BenKohn2004/LFC_Overlay_and_Camera_Tracking/Raspberry_Pi_Station/assets/Blue Rectangle.png

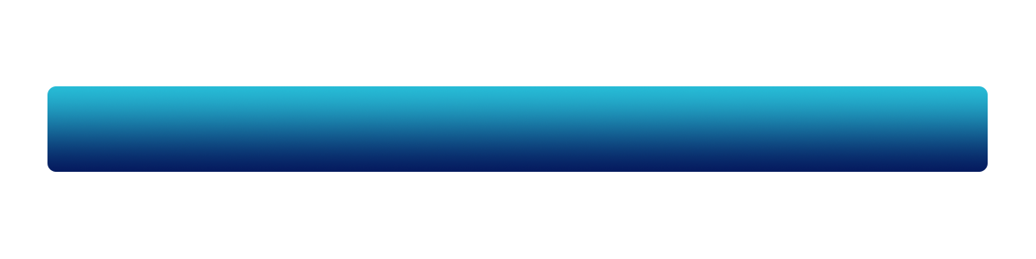
Raspberry_Pi_Station/assets/Blue Rectangle.png
