BenKohn2004/LFC_Overlay_and_Camera_Tracking/Scoring Machine Integration/Schematic_Favero-Parser-and-Receiver_2025-12-16.pdf

# Favero Parser and Transmitter Receiver and Relays

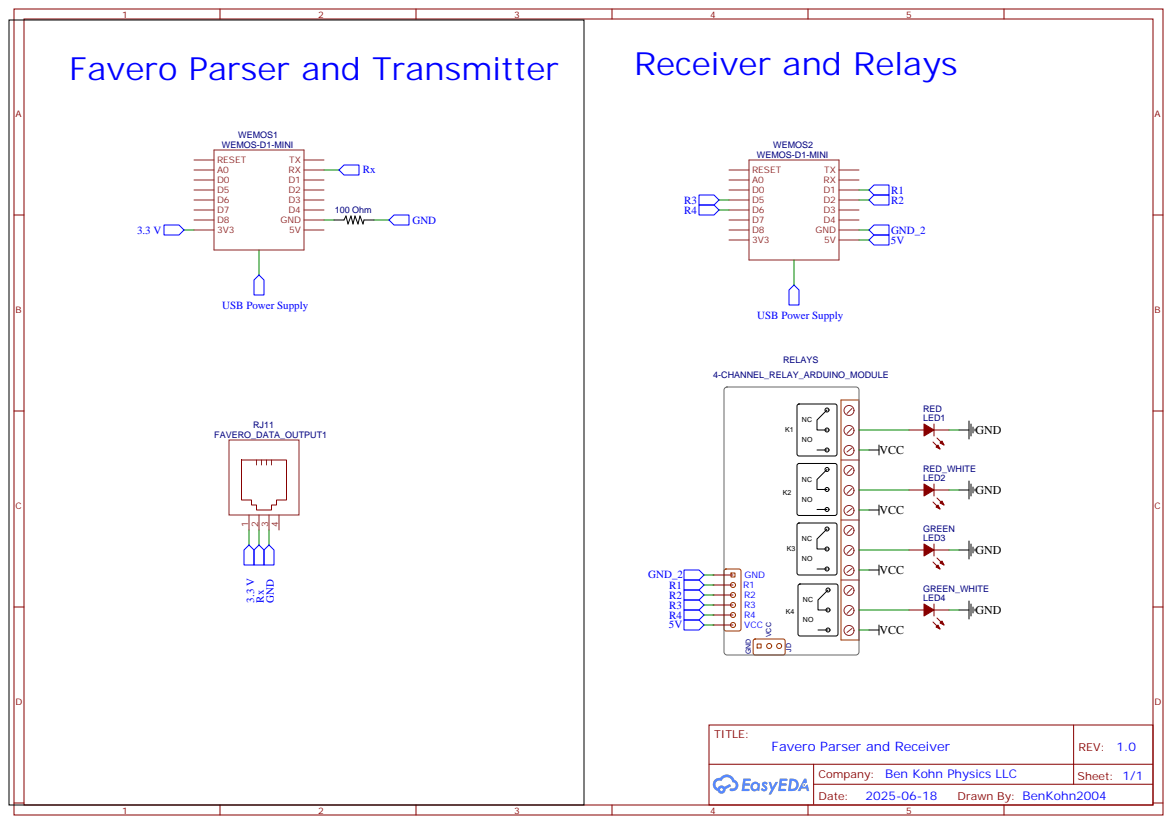
[picture p6: page 1]

Company: Ben Kohn Physics LLC
