BenKohn2004/LFC_Overlay_and_Camera_Tracking/Camera Tracking System/Schematic_Favero_Optical_Encoder_2026-08-30.pdf

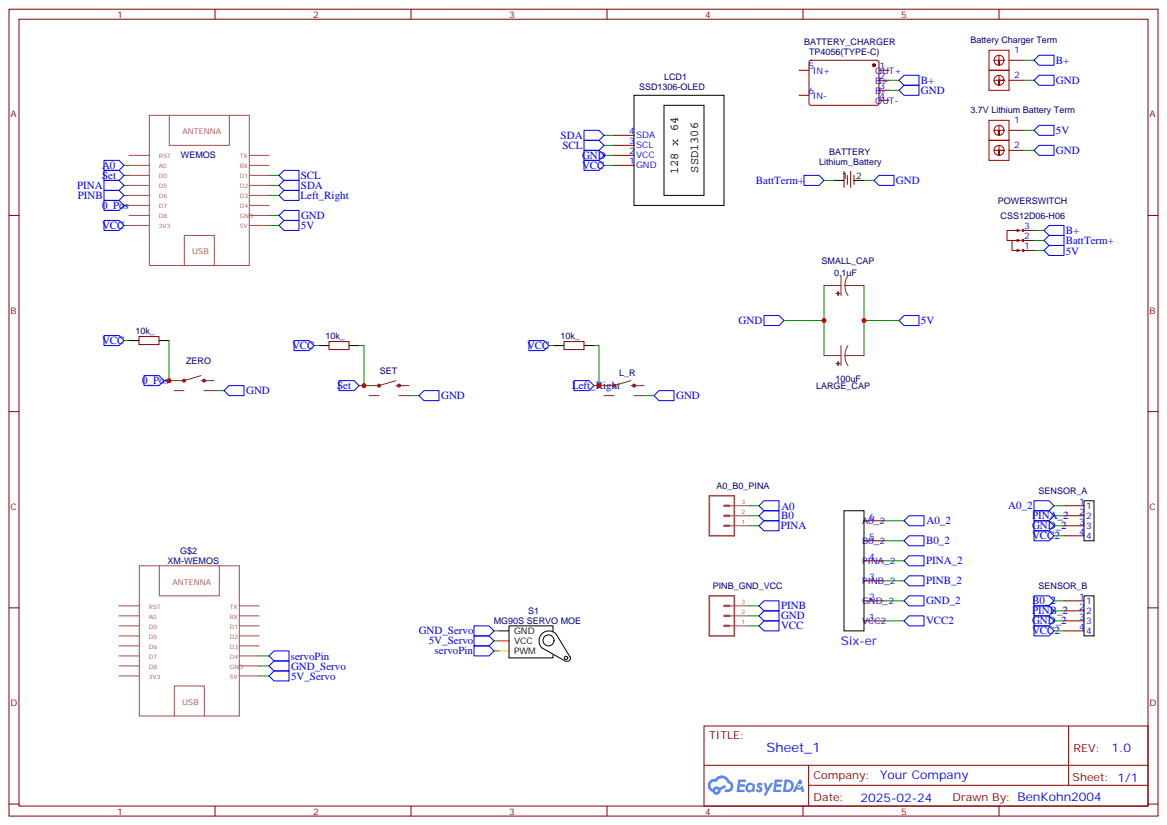
[picture p7: page 1]
