BenKohn2004/LFC_Overlay_and_Camera_Tracking/(commit log)

2026-01-23 Rename Favero Reel Encoder Tiled.pdf to Camera Tracking System/Favero Reel Encoder Tiled.pdf
2026-01-23 Rename Gerber_Favero_Optical_Encoder_PCB.zip to Camera Tracking System/Gerber_Favero_Optical_Encoder_PCB.zip
2026-01-23 Rename Wemos_Camera_Servo Original.ino to Camera Tracking System/Wemos_Camera_Servo Original.ino
2026-01-23 Rename Wemos_Camera_Servo Rev 1.ino to Camera Tracking System/Wemos_Camera_Servo Rev 1.ino
2026-01-23 Rename Wemos_Reel_Encoder.ino to Camera Tracking System/Wemos_Reel_Encoder.ino
2026-01-23 Rename Schematic_Favero-Parser-and-Receiver_2025-12-16.pdf to Scoring Machine Integration/Schematic_Favero-Parser-and-Receiver_2025-12-16.pdf
2026-02-08 Add files via upload
    An arduino sketch meant to allow for the calibration of Hall Effect Sensors and determine an optimal spacing
2026-07-19 Broadcast unconditionally in SoftAP mode
    The softAPgetStationNum() gate froze all telemetry whenever the ESP8266
    AP expired a listen-only station (a UDP receiver never transmits, so the
    AP drops it after a few idle minutes). Symptom: intermittent loss of all
    packets until the receiver re-announced itself. Ten 67-byte packets per
    second cost negligible airtime even with no stations attached.
2026-07-20 Add Raspberry Pi fencing station (recording + touch replay + bout browser)
    Self-contained Pi 5 touchscreen station that pairs with the Skewered UDP
    transmitter: live webcam view with the Favero-style overlay burned in,
    activity-triggered 720p30 recording in crash-safe 5-minute segments,
    SQLite database of bouts/touches/cards, on-screen bout browser with
    looping touch replays, tap-to-edit fencer nameplates with recent-name
    quick select, and a debug-beacon logger for transmitter health.
2026-07-20 Add club logo circles with tap-to-pick, search, and name association
    Circular club logos between nameplate and score plate, burned into
    recordings. Tapping opens a picker: the club last paired with that
    fencer's name first, no-club and USA options always available, and
    live filtering by typed text. Picking a name whose club is known
    applies the logo automatically. make_logos.py converts arbitrary
    club images into uniform white-disc circles.
2026-07-20 Harden transmitter: bounded parser, debug beacon, TX throttle + dead-man
    Three reliability upgrades from field failures:
    - Serial parsing bounded to 8 ms per loop so RS-485 line noise can
    never starve the UDP heartbeat.
    - 1 Hz debug beacon on port 4211 (uptime, loop count, rx bytes, valid
    packets, send failures, free heap, station count) for over-the-air
    health diagnosis.
    - Send throttle raised to 30 ms minimum gap (~100 sends/s starved lwIP
    TX buffers at ~4 endPacket failures/s) and a dead-man switch: if no
    send succeeds for 15 s the chip restarts itself, converting a wedged
    TX path from a silent evening into a ~20 s blip.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
2026-07-21 Add YouTube upload: bout cutting, wifi picker, resumable uploader
    From the bout browser, UPLOAD ALL / per-bout UPLOAD cuts each bout (first
    touch to last, 20-min cap, stream copy) and uploads it privately, titled
    'Name vs Name - date (score)' with the touch list as description. A WIFI
    button scans and joins an internet network on the touchscreen (uploading
    is an after-practice step; the box AP has no internet). A per-bout
    youtube_id prevents re-uploads.
    yt_upload.py is stdlib-only (no pip deps, since the Pi has no internet for
    installs) and does resumable chunked uploads. oauth_link.py runs once on a
    PC with a browser to produce the refresh token. Secrets (client JSON,
    yt_token.json) stay o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
2026-07-23 Transmitter: hardware UART for box input + reset-reason in debug beacon
    Fixes a hardware-watchdog reboot loop (Wemos reset every 1-2 min, one
    NO BOX SIGNAL each). The debug beacon's new reset-reason byte labelled
    every reset HW-watchdog, with healthy internals right up to the reset,
    and only with the box connected -- SoftwareSerial at 115200 was starving
    interrupts. Moved box input to the hardware UART via Serial.swap()
    (UART0 RX -> GPIO13/D7, the pin the converter already uses, so no
    rewiring). The bare UART needs the RX pull-up SoftwareSerial provided;
    setting pinMode(13, INPUT_PULLUP) BEFORE the swap keeps the pin on the
    UART (after-swap re-muxes it off). USB serial debug is lost (the WiF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
2026-07-31 Capture the cold-start window: run the debug logger from boot
    The transmitter intermittently has no data at the Pi on a cold start. The
    telemetry logger could not diagnose it because start_station.sh launches it
    only after waiting up to 30 s for the webcam -- past the window in question.
    Run it from a systemd unit at boot instead, deliberately not ordered after
    network-online.target: binding 0.0.0.0 works while the link is down, and
    waiting would hide the startup gap being measured.
    Also log Wi-Fi association transitions. Without them a quiet stretch is
    ambiguous -- a wedged transmitter and a Pi that has not joined SkeweredNet
    yet produce an identical hole in the log. The AP's BSSID is pin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
2026-08-02 Logger: keep the Pi's serial-reinit support, use a monotonic clock
    Two things found by diffing against the copy actually running on the Pi.
    The deployed debug_logger.py was ahead of git: it parses a 28-byte beacon
    carrying a serial_reinits counter and flags SERIAL-REINIT. Rewriting from the
    committed version would have silently dropped that, and it is directly
    relevant to the startup fault being chased. Merged back in, so all three
    beacon widths (26/27/28) are handled. Note the firmware emitting 28-byte
    beacons is not in this repo either.
    The Pi has no working RTC -- it boots at 1970 and timedatectl reports the
    clock as unsynchronized, currently a couple of days off. It only corrects
    when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
2026-08-02 Add an RS-485 line probe to tell "box off" apart from "link broken"
    Analysis of two weeks of wemos_debug.log (134 transmitter boot sessions)
    narrowed the startup fault considerably:
    - Wi-Fi association is not involved. The debug beacon arrives over the same
    radio while rx_bytes sits at zero, so the Pi is associated and the fault is
    entirely on the serial side.
    - The line is not being jammed. A jam would show rx climbing while valid
    stayed flat; instead rx is flat at ZERO in 19 of 22 bad sessions, and the
    three exceptions grew by 59, 1 and 2 bytes over minutes.
    - The UART is not what wedges. The deployed firmware's serial re-init fired
    332 times and only 3 were followed by any vali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
2026-08-02 Probe: gate on valid frames, not raw bytes
    The live link is trickling roughly 10 bytes/s of noise with zero valid frames
    -- consistent with the absent or weak failsafe biasing the Pi README warns
    about. Gating the probe on "no raw bytes for 5 s" would have reset the timer
    every second, so it would never have fired in exactly the state worth
    diagnosing.
    Gate on validPackets instead. The box emits valid frames continuously while
    powered, so "no valid frame for 5 s" means the link is genuinely not
    delivering and there is nothing for the probe to corrupt.
    Recompiled clean for esp8266:esp8266:d1_mini. Still not flashed or tested on
    hardware.
2026-08-02 Vendor the transmitter firmware actually running on the box
    The sketch in this repo was two revisions behind what is flashed. The live
    copy lives in the local Arduino sketchbook and adds the serial self-heal:
    initBoxSerial() (Serial.end, pull-up, begin, swap) re-run whenever the box
    line has been silent for 10 s, with a serialReinits counter reported in a
    28-byte debug beacon.
    This temporarily drops the line probe added in 1caf622, which was written
    against the stale base. It is re-applied on top of this commit, so the probe
    diff is now readable against the code that actually runs.
2026-08-02 Re-apply the line probe on top of the deployed firmware
    Rebased onto the real sketch, so it reuses initBoxSerial() to restore the
    pull-up and UART after re-muxing GPIO13, rather than duplicating that
    sequence. Beacon goes 28 -> 29 bytes with line_probe appended.
    The probe gates on valid frames while the existing self-heal gates on raw
    bytes, and that difference is deliberate: any byte proves the UART is alive
    (what the self-heal cares about), but a line trickling noise with zero valid
    frames is exactly the state the probe needs to inspect.
    Flashed to the Strip10 board and confirmed working: the beacon now carries
    line=, and the Pi logger decodes it.
    No .bin flash backup was taken -- read_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
2026-08-02 Record the line-probe calibration and what the bench session ruled out
    The probe was calibrated against known physical states: LOW = pair open
    (cable to the box unplugged or broken), driven-high = pair connected and
    idling correctly even with the box off, FLOATING = high-Z at the converter.
    A silent link now identifies its own cause instead of being ambiguous.
    The bench session ruled out more than it confirmed. Not Wi-Fi association
    (the beacon arrives while rx is zero), not a jammed bus (rx is flat at zero,
    not climbing), not the UART wedging (332 re-inits, 3 recoveries), not missing
    failsafe bias (the line idles driven-high with the pair connected), and not an
    obviously intermittent D6/D7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
2026-08-02 Run the station without a camera, and survive losing one
    station.py exited the moment the capture returned a short read, so the whole
    app required a webcam to start -- reviewing a past session meant reattaching
    the camera. The same code path also meant a camera glitch mid-tournament
    killed the station outright, and since the XDG autostart only runs at login it
    stayed dead for the rest of the day.
    The capture now degrades instead of exiting. With no camera the live view is a
    placeholder, the loop is paced by a pygame clock (the blocking frame read used
    to pace it, so without one it would spin a core flat), and open_camera() is
    retried every 5 s so a camera plugged in later is picked up.
    Rec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
2026-08-02 Add bout deletion with a confirmation gate
    DELETE sits left of UPLOAD on the touches screen, in the slot WIFI uses on the
    bouts screen. Both are in the same branch, so neither is offered while an
    upload or export is running.
    Tapping it opens MODE_CONFIRM, a generic yes/no gate that carries the action to
    run on confirmation, so it can front any destructive operation later. CANCEL is
    on the left and wider than DELETE -- on an 800x480 touchscreen the safe choice
    should be the easy one to hit.
    Deletion removes the bout row and its events, and the per-bout export in
    UPLOAD_DIR. It deliberately leaves the recording segments alone: those are
    time-based files shared by every bout in a session. Ver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
2026-08-02 Slow-motion replay with pause and frame stepping
    The replay loop already runs at 30 fps, so holding each frame for N iterations
    IS 1/N speed -- 10%, 25% and 50% need no re-encoding and no seeking.
    Stepping backwards does need work: normal replay streams from ffmpeg one frame
    per loop and cannot be rewound. Entering slow motion decodes the clip into
    memory instead. Measured on real footage: 180 frames, 1.83 s, 186 MB, against
    7 GB free. Paid only on entering slow motion, and released by stop_playback,
    so ordinary replay is untouched.
    The decode blocks the loop for nearly two seconds, which on a touchscreen
    reads as a hang, so selecting a speed defers the work by one iteration -- the
    "Loadin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
2026-08-02 Slow-motion bar to the top, and hold-to-scrub on the frame arrows
    The control bar moves from the bottom of the frame to just under the replay
    banner. In fencing the bottom of frame is feet, which matter; the top is
    usually ceiling.
    Holding a frame arrow now scrubs. The panel already reports a sustained press
    -- the 2 s hold-to-exit on the live view depends on it -- so this needed only
    the press position kept for the duration of the press rather than just at the
    tap. Repeat starts after 0.4 s so an ordinary tap is exactly one frame, then
    runs at one frame per 4 loop iterations: 7.5 frames/sec, matching the 25%
    playback speed. Stepping wraps at the clip ends, consistent with slow motion
    alrea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
2026-08-02 Show the slow-motion bar only while slow motion is engaged
    During ordinary review the bar carried nothing but a single button, so it was
    spending a strip of picture to no purpose. It now appears only when there is
    status to show -- loading, the speed menu, or slow motion running. The lone
    SLOW MOTION button draws its own background, so it stays legible over the
    video without it.
2026-08-03 Forward the hit age from the box to the Pi
    The Skewered protocol carries "milliseconds since the hit occurred" in bytes
    7-9, and this transmitter has been receiving and discarding it: those indices
    sit in the change detector's ignore list, correctly (they tick at 200 Hz and
    would make every packet look different) but nothing ever decoded them.
    That field is what makes overlay/video alignment tractable. The box streams
    state every ~5 ms while this transmitter throttles to 10-33 Hz, so a light's
    arrival time at the Pi says little about when it actually happened. The age
    travels with the packet and is true regardless of throttling or Wi-Fi jitter,
    which removes the telemetry-side variance enti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
2026-08-04 Record MJPEG, re-encode on export
    Overlay/video sync was drifting unpredictably: measured across ten touches,
    the offset between a light appearing in the picture and appearing in the
    overlay ranged over 200 ms, mean +33 ms, sd ~70 ms. The hit-age field showed
    the telemetry side is not responsible -- 7 to 28 ms on every sample -- so
    essentially all of it comes from the capture pipeline.
    The mechanism is back-pressure. A composited frame is 2.76 MB written into a
    64 KB pipe, so the loop advances at the encoder's pace. x264 costs more on
    motion and much more on a keyframe (forced every 2 s); a frame that overruns
    the 33 ms budget stalls the loop, frames queue upstream in v4l2, and since the
    lo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
2026-08-09 Capture natively at 720p instead of 1080p-then-downscale
    The live view had drifted to 1-2 seconds behind reality. The capture pipeline
    was grabbing 1920x1080 MJPEG and scaling every frame to 1280x720 -- paying to
    decode 1080p and then discarding 55% of the pixels, when 720p is the only size
    the station ever uses.
    Measured on this Pi, same frame rate either way:
    1080p capture + scale : 29.11 fps, 111% of a core
    720p capture, native : 29.34 fps, 39.8% of a core
    That returns roughly 70% of a core to the loop, and the lag is gone.
    Getting there took three wrong turns worth recording. The encoder was blamed
    first: MJPEG (constant per-frame cost, 4x headroom) changed nothing, and
    x264 ul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
2026-08-09 Add DELETE ALL to the bouts screen
    The Pi is a buffer, not an archive -- clips go to YouTube for long-term
    storage -- so clearing the whole history needs to be one action rather than
    deleting bouts one at a time.
    Sits left of WIFI, and is disabled while recording: wiping the footage with a
    session live would pull files out from under the running encoder.
    Two choices behind the confirmation. BOUTS clears the history but leaves the
    recordings, matching what single-bout delete does. + VIDEO also reclaims the
    footage, which single-bout delete deliberately avoids because segments are
    shared between bouts in a session -- that reasoning does not apply when every
    bout is going, since no segment is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
2026-08-10 Move the SoftAP to channel 11
    ESP-NOW on an ESP8266 defaults to channel 1, and so did WiFi.softAP() with no
    channel argument -- so a room with other Wemos boards running stock firmware
    puts every one of them directly on top of the scoring link. Channels 1 and 11
    do not overlap at all, so this separates them without touching a single other
    board.
    It matters more for this link than for most traffic: telemetry goes to the
    subnet broadcast address, and 802.11 broadcast frames carry no acknowledgement
    and no retransmission. A collided packet is lost silently, as a dropped state
    update, so contention degrades the scoreboard before it degrades anything
    else in the room.
    A scan at the bench also f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
2026-08-17 Reset the box link at boot, and probe which pin the data is on
    The cold-boot wedge never yielded to Serial.end()/begin(): 332 self-heal
    re-inits produced 3 recoveries. That sequence hands GPIO13 straight from one
    driven state to another and never lets it float, so resetBoxLink() parks D6/D7
    at INPUT with no pull-up for 50 ms first -- as close to unplugging the pin as
    software gets. It runs in setup() and again at 2/6/12 s while no valid frame
    has arrived, and the 10 s self-heal now calls it too.
    Also adds a pin traffic probe, because "RXD goes to D7" does not say whether
    D7 carries data in or out: the converter modules label those pins from either
    end's point of view. It counts transitions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
2026-08-17 Vendor the station.py actually running on the Pi
    The Pi's copy had drifted ahead of the repo again -- this time carrying the
    audio capture work: the mic pinned by ALSA CARD name rather than index (the
    webcam presents a capture device too, so hw:1,0 reorders between boots and
    would silently record the wrong input), and audio_ok() so a missing or
    still-enumerating mic degrades to video-only instead of taking the recorder
    down with it.
    Committing it as it runs, before the next deploy overwrites it. That drift has
    now bitten twice; diff before copying anything onto that box.
2026-08-17 Drop the SoftAP keepalive now that the box is read over BLE
    This existed because the ESP8266's access point silently expired the Pi as a
    station: the Pi only ever listened to broadcasts and never transmitted, so the
    AP aged it out and telemetry stopped until it announced itself again. A "ka"
    datagram every 10 s kept the association alive.
    There is no access point any more -- the BLE bridge replaces the transmitter
    entirely -- so this only sends to an address nothing answers. Restore it if the
    wired transmitter ever comes back; the expiry bug comes back with it.
2026-08-17 Read the box over BLE, retiring the whole wired chain
    The Skewered protocol documents a Bluetooth transport alongside RS-485: the box
    advertises as SkF:<strip> under manufacturer ID 0x0E88, and every advertisement
    carries a full State data packet -- the same one the serial 0xEE frame wraps.
    So the RJ11 cable, the MAX485, the ESP8266 transmitter, its SoftAP and the
    BSSID pinning are all optional.
    ble_bridge.py decodes those advertisements and re-emits the transmitter's exact
    71-byte payload on UDP 4210, so station.py needs no changes at all. BlueZ over
    D-Bus using python3-dbus and PyGObject, both already on the Pi -- no pip, no
    bleak. The advertised payload is the firmware's array minus its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
2026-08-17 Add a BLE capture tool for studying the box's hit timing
    Logs every distinct advertisement with millisecond timestamps and the RAW
    3-bit light status per side, rather than the booleans the bridge exposes.
    That distinction is the point: short/whipover and late have no boolean, so
    they are invisible in the normal path, and they are exactly the cases where
    the timing bytes stop meaning "age".
    Passive by design -- it attaches to the signals the bridge already triggers
    and only starts discovery if nothing else has, so it can run against a live
    station without disturbing it.
2026-08-17 Use the box's hit timing: back-date touches, and show late hits
    Measured against the box over five light episodes, the timing bytes behave
    two different ways depending on the light status, and the station was reading
    them as one thing.
    For a valid or non-valid light the value is a real age, ticking 1 ms per
    elapsed ms (mean ratio 0.997 over 30 intervals, including through dropped
    advertisements) and clamping at 999. The first packet carrying a hit already
    reports it as 7-93 ms old, so arrival time was never a good timestamp for
    something judged in milliseconds. Touches are now back-dated by that age,
    which removes the error rather than averaging it -- and since clip boundaries
    and replay po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
2026-08-18 README: Skewered over BLE, and the Pi station as the main path
    The described system no longer exists. Scoring data came from a Favero FA-05
    through an RJ11 data port, was parsed by an ESP8266 and relayed over ESP-NOW to
    a receiver on a laptop running OBS. It now comes from a Skewered box, which
    advertises its whole state over Bluetooth LE, straight to the Raspberry Pi --
    no data cable, no RS-485 converter, no transmitter board, no laptop.
    Camera tracking is unchanged and still ESP-NOW, so the architecture section now
    separates the two radios rather than describing one network doing both jobs.
    The Favero OBS bridge and the Wi-Fi transmitter still work and are still in the
    tree, so they are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
2026-08-18 Remove the YouTube uploader and its OAuth helper
    The station saves bouts to a Samba share now, so nothing calls these. Removing
    them rather than leaving them dormant is the point: the reason for the change
    was that uploading required a long-lived refresh token on a box that travels to
    clubs, and keeping the machinery around invites putting the token back.
    The credential itself has been revoked from the Google account and
    yt_token.json deleted from the Pi. Note that revoking is the step that matters
    -- deleting the file alone leaves a working credential in any copy or backup.
    The station README described the old upload flow throughout; it now documents
    the share, and its file table lists bl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
2026-08-18 Put the database in WAL mode, and let setup_share.sh run unattended
    An export died with "database is locked". The database was in the default
    rollback journal mode, where a reader blocks a writer -- and the export worker
    writes from its own connection while the main loop is continuously reading
    bouts for the browser, so the two collide. WAL allows one writer alongside
    readers, which is exactly this shape. It is a property of the file, so every
    connection inherits it, including the workers. Their timeout goes 10s -> 30s as
    well, since losing a cut to a lock wastes the whole ffmpeg run.
    setup_share.sh now skips the password step when there is no terminal, rather
    than hanging on a prompt nobod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
2026-08-19 Add files via upload
    Current Gerber File of the Reel Encoder
2026-08-22 Copy videos to a USB drive, and drop the Samba share
    Samba worked, but its setup cost is per-person rather than per-system: install
    it, set a password, find the IP, type a UNC path, then handle the address
    changing between networks. Every one of those is a place someone who did not
    build this stops and asks for help. A USB drive has none of it, works the same
    on Windows, Mac and Linux, and needs no network at all -- which also means a
    new user never has to get the Pi onto Wi-Fi.
    Removing SMB rather than keeping both is deliberate: sharing this means using
    the same path everyone else uses, so its rough edges are felt rather than
    guessed at.
    Plug a drive in and the USB button becomes active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
